open-rdc/harvesting_endeffector/claws_endeffector/stl_for_urdf/main_link.stl

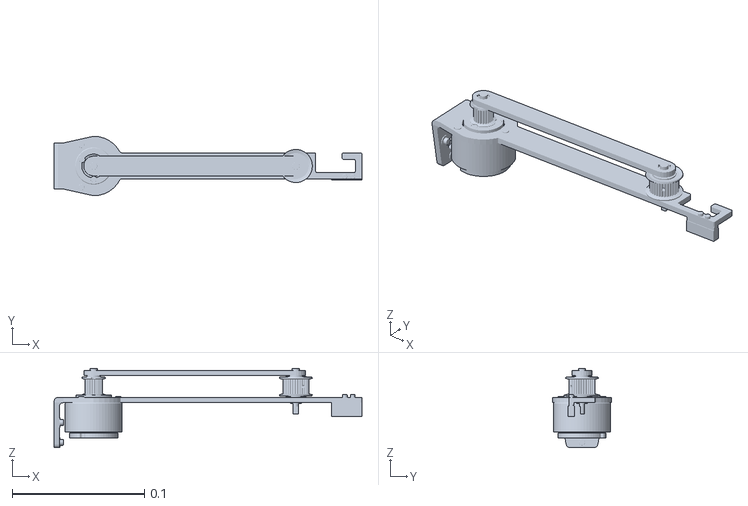
[picture p1: CAD file, 2025-06-20]
claws_endeffector/stl_for_urdf/main_link.stl
0.233 x 0.045 x 0.0599
