open-rdc/harvesting_endeffector/linear_cutting_endeffector/stl_for_urdf/main_link.stl

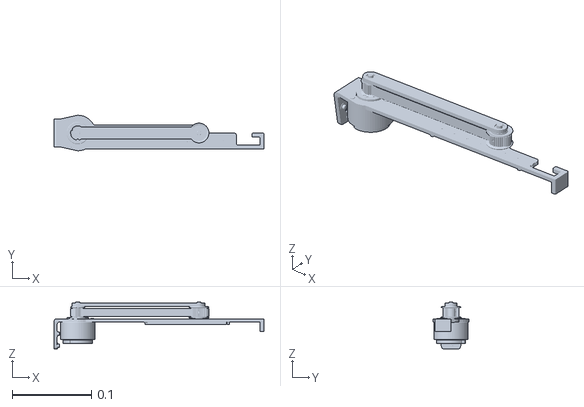
[picture p2: CAD file, 2025-06-20]
linear_cutting_endeffector/stl_for_urdf/main_link.stl
0.265 x 0.045 x 0.0592
