open-rdc/harvesting_endeffector/claws_endeffector/stl_for_urdf/wrist_link.stl

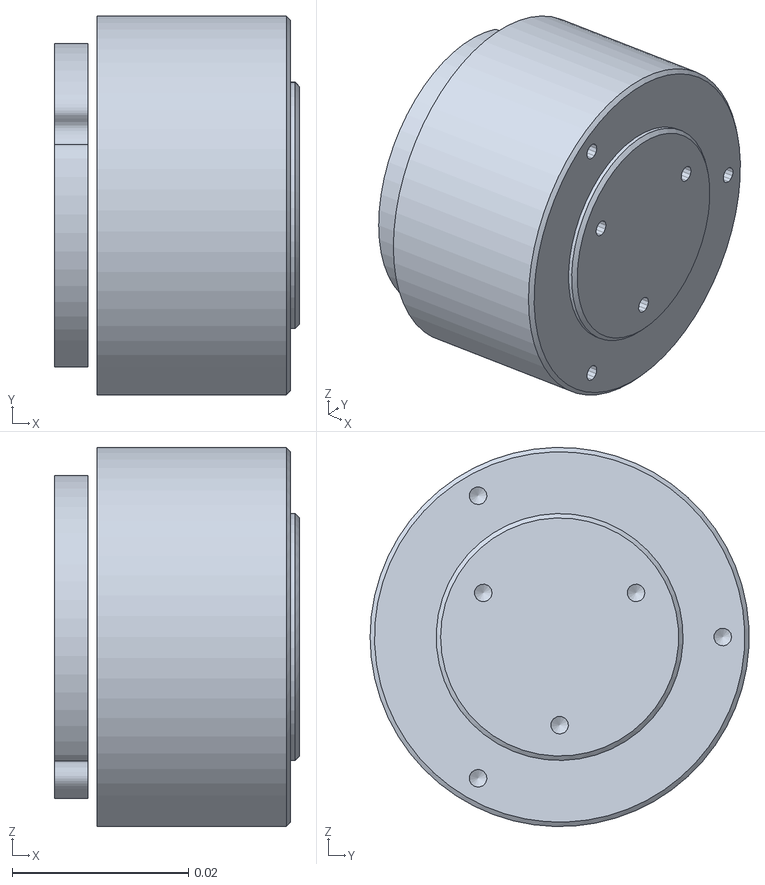
[picture p3: CAD file, 2025-06-20]
claws_endeffector/stl_for_urdf/wrist_link.stl
0.0278 x 0.043 x 0.043
