open-rdc/harvesting_endeffector/Vibrating_knife_endeffector/model/stl/knife_attachment.stl

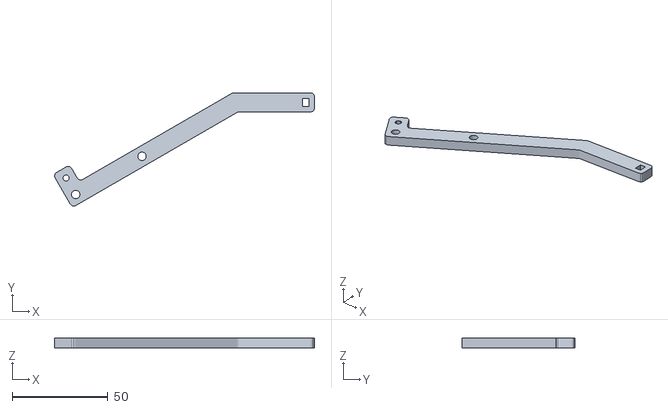
[picture p4: CAD file, 2024-10-24]
Vibrating_knife_endeffector/model/stl/knife_attachment.stl
135.9 x 59.3 x 5.00
