open-rdc/harvesting_endeffector/linear_cutting_endeffector/stl_for_urdf/cutter_link.stl

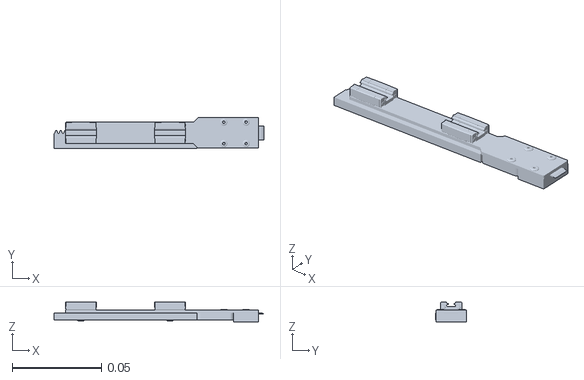
[picture p5: CAD file, 2025-06-20]
linear_cutting_endeffector/stl_for_urdf/cutter_link.stl
0.118 x 0.0171 x 0.011
