open-rdc/harvesting_endeffector/Vibrating_knife_endeffector/model/stl/stem_part.stl

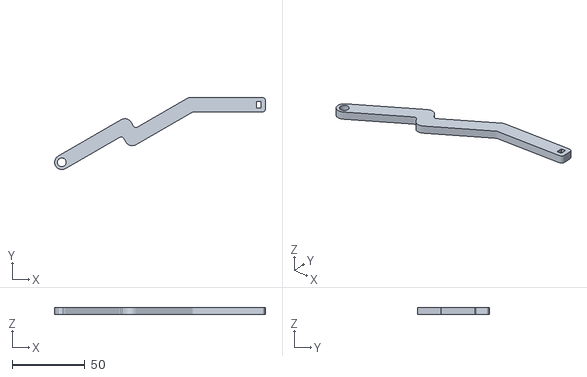
[picture p6: CAD file, 2024-10-24]
Vibrating_knife_endeffector/model/stl/stem_part.stl
144.8 x 49.4 x 5.00
