open-rdc/harvesting_endeffector/claws_endeffector/stl_for_urdf/blade_link.stl

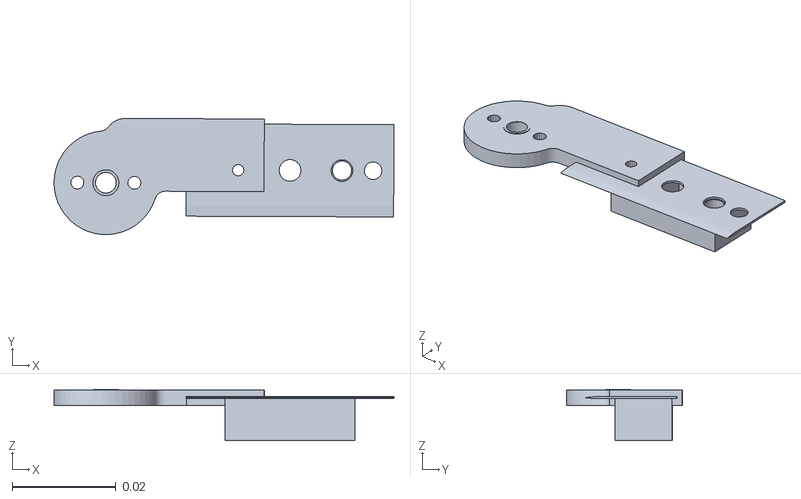
[picture p7: CAD file, 2025-06-20]
claws_endeffector/stl_for_urdf/blade_link.stl
0.0655 x 0.0224 x 0.0099
