open-rdc/harvesting_endeffector/Vibrating_knife_endeffector/model/stl/base_part_attachment_ver2.stl

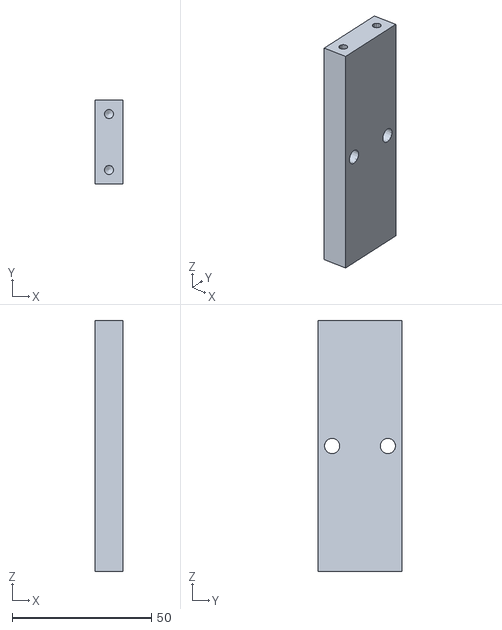
[picture p8: CAD file, 2024-10-15]
Vibrating_knife_endeffector/model/stl/base_part_attachment_ver2.stl
10.0 x 30.0 x 90.0
