open-rdc/harvesting_endeffector/Vibrating_knife_endeffector/model/stl/spacer4.4mm_in3.5mm.stl

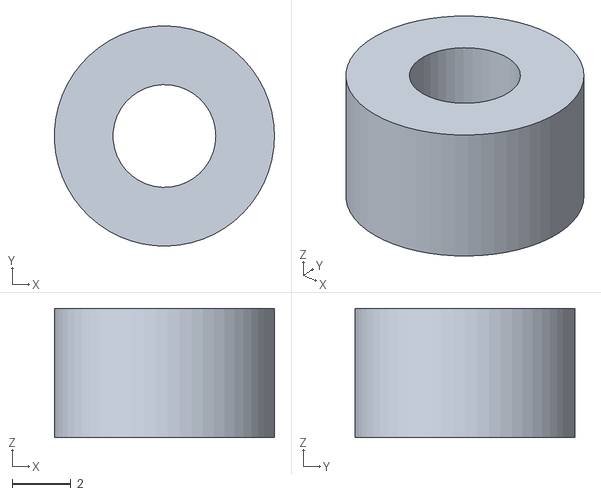
[picture p9: CAD file, 2024-10-13]
Vibrating_knife_endeffector/model/stl/spacer4.4mm_in3.5mm.stl
7.49 x 7.50 x 4.40
