open-rdc/harvesting_endeffector/Vibrating_knife_endeffector/model/stl/knife_model.stl

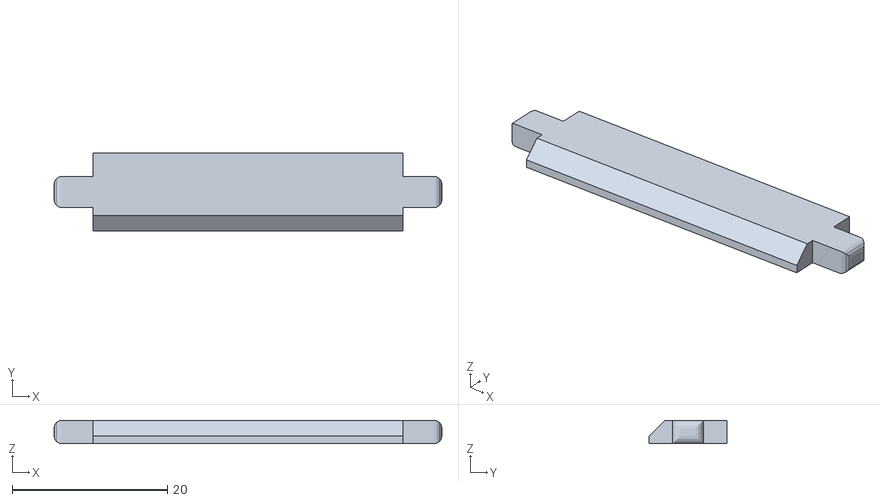
[picture p10: CAD file, 2024-10-12]
Vibrating_knife_endeffector/model/stl/knife_model.stl
50.0 x 10.0 x 3.00
