open-rdc/harvesting_endeffector/Vibrating_knife_endeffector/model/stl/spacer2mm_in3.5mm.stl

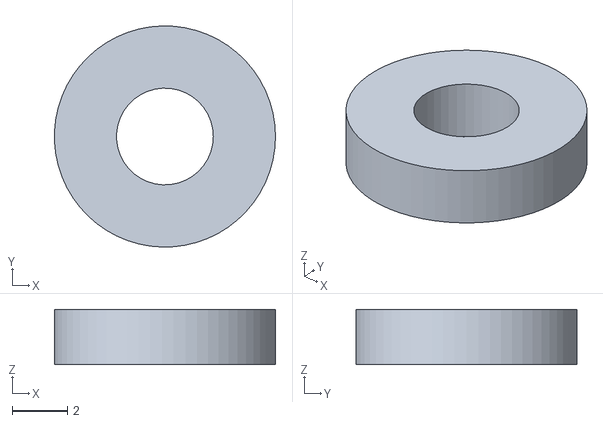
[picture p12: CAD file, 2024-10-12]
Vibrating_knife_endeffector/model/stl/spacer2mm_in3.5mm.stl
7.99 x 8.00 x 2.00
