open-rdc/harvesting_endeffector/Vibrating_knife_endeffector/model/stl/base_part_finger_ver2.stl

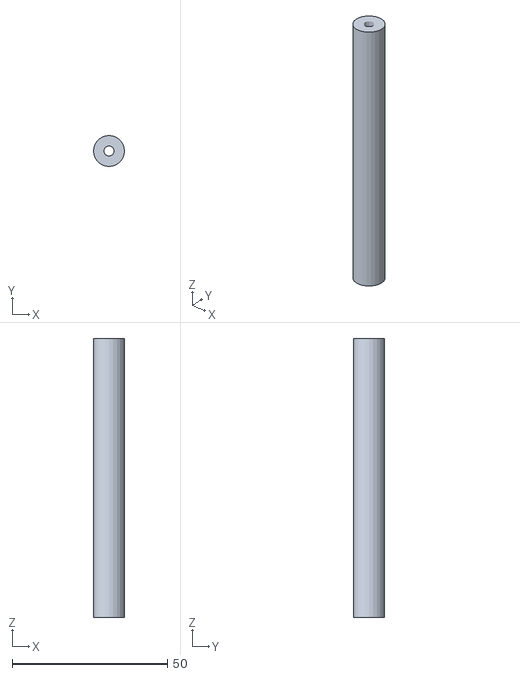
[picture p14: CAD file, 2024-10-12]
Vibrating_knife_endeffector/model/stl/base_part_finger_ver2.stl
10.0 x 10.0 x 90.0
