open-rdc/harvesting_endeffector/Vibrating_knife_endeffector/model/stl/stem_part_atachment.stl

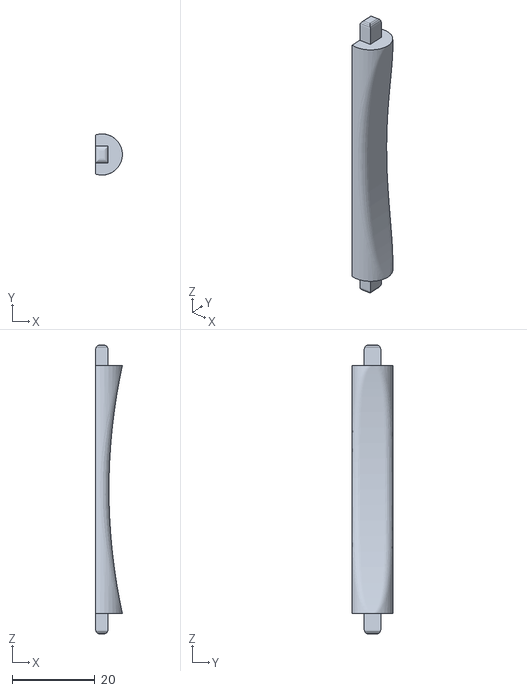
[picture p15: CAD file, 2024-10-12]
Vibrating_knife_endeffector/model/stl/stem_part_atachment.stl
6.50 x 10.0 x 70.0
