open-rdc/harvesting_endeffector/Vibrating_knife_endeffector/model/stl/spacer14mm_in3.3mm.stl

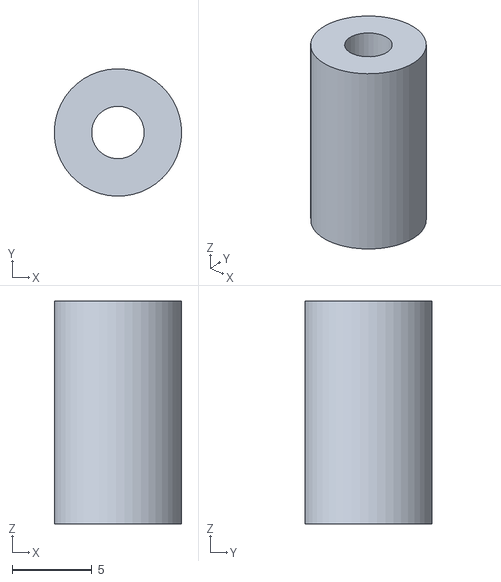
[picture p16: CAD file, 2024-10-10]
Vibrating_knife_endeffector/model/stl/spacer14mm_in3.3mm.stl
7.99 x 8.00 x 14.0
