open-rdc/harvesting_endeffector/Vibrating_knife_endeffector/model/stl/spacer4.4mm_in3.3mm.stl

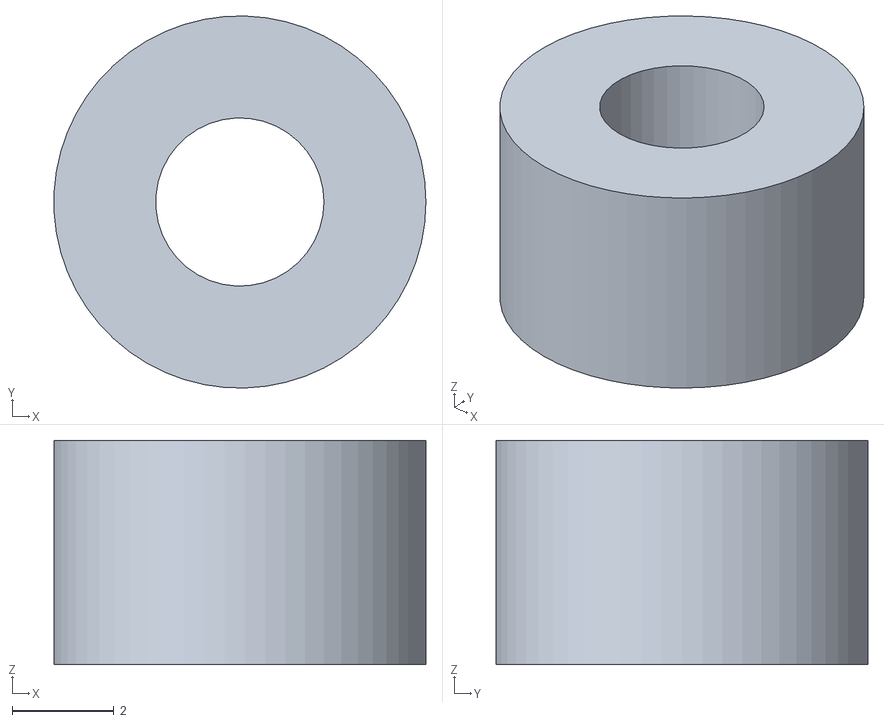
[picture p17: CAD file, 2024-10-09]
Vibrating_knife_endeffector/model/stl/spacer4.4mm_in3.3mm.stl
7.29 x 7.30 x 4.40
