open-rdc/harvesting_endeffector/Vibrating_knife_endeffector/model/stl/spacer20mm_in4.3mm.stl

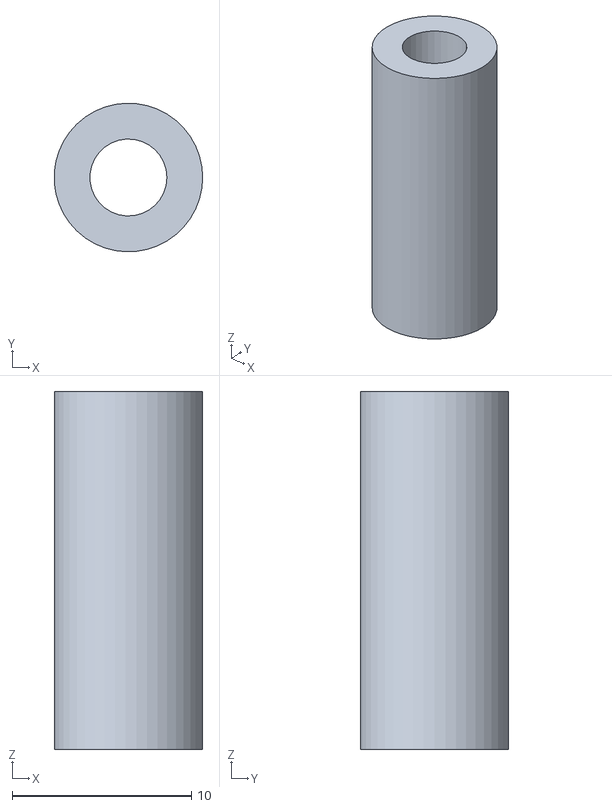
[picture p18: CAD file, 2024-10-09]
Vibrating_knife_endeffector/model/stl/spacer20mm_in4.3mm.stl
8.29 x 8.29 x 20.0
