open-rdc/harvesting_endeffector/Vibrating_knife_endeffector/model/stl/finger_M.stl

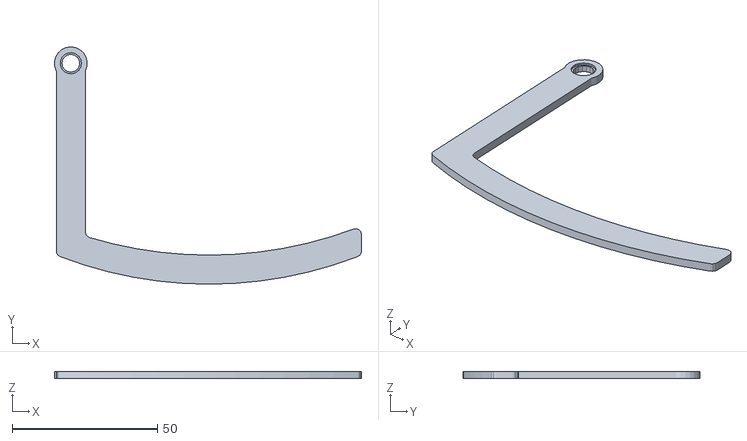
[picture p19: CAD file, 2024-10-09]
Vibrating_knife_endeffector/model/stl/finger_M.stl
105.6 x 81.7 x 2.50
