open-rdc/harvesting_endeffector/Vibrating_knife_endeffector/model/stl/finger_L.stl

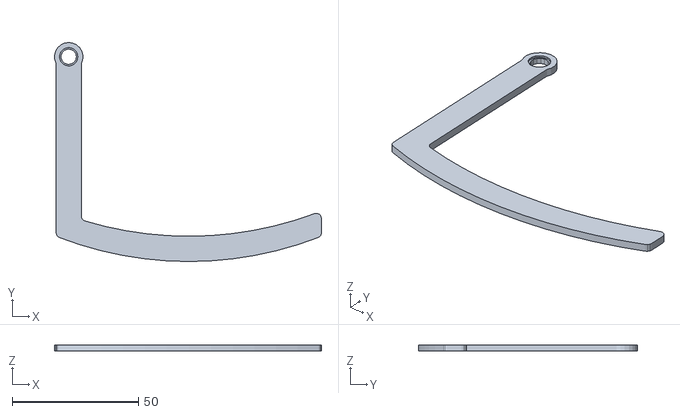
[picture p20: CAD file, 2024-10-09]
Vibrating_knife_endeffector/model/stl/finger_L.stl
105.6 x 86.7 x 2.50
