open-rdc/harvesting_endeffector/Vibrating_knife_endeffector/model/stl/base_part.stl

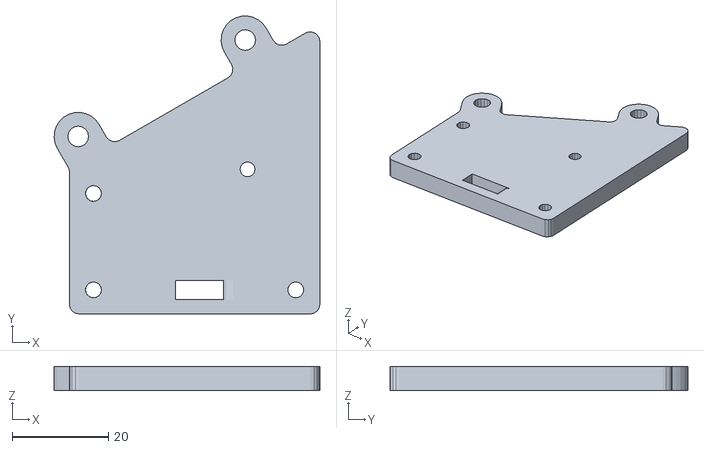
[picture p21: CAD file, 2024-10-09]
Vibrating_knife_endeffector/model/stl/base_part.stl
55.1 x 61.8 x 5.00
