open-rdc/harvesting_endeffector/Vibrating_knife_endeffector/model/stl/finger_S.stl

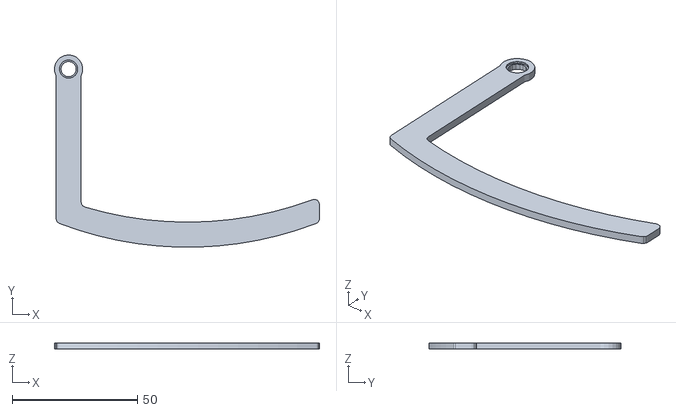
[picture p22: CAD file, 2024-10-09]
Vibrating_knife_endeffector/model/stl/finger_S.stl
105.6 x 76.6 x 2.50
