open-rdc/harvesting_endeffector/(list of files, cad)

Other CAD files:
linear_cutting_endeffector/stl_for_urdf/wrist_motor_link.stl
Vibrating_knife_endeffector/Vibration_motor.ipt
Vibrating_knife_endeffector/model/OldVersions/base_part.0003.ipt
Vibrating_knife_endeffector/model/OldVersions/base_part_attachment.0002.ipt
Vibrating_knife_endeffector/model/OldVersions/base_part_attachment_ver2.0002.ipt
Vibrating_knife_endeffector/model/OldVersions/base_part_finger_ver2.0001.ipt
Vibrating_knife_endeffector/model/OldVersions/green_pepper_model.0002.ipt
Vibrating_knife_endeffector/model/OldVersions/knife_attachment.0006.ipt
Vibrating_knife_endeffector/model/OldVersions/knife_model.0001.ipt
Vibrating_knife_endeffector/model/OldVersions/spacer14mm_in3.3mm.0004.ipt
Vibrating_knife_endeffector/model/OldVersions/spacer2.5mm_in3.3mm.0002.ipt
Vibrating_knife_endeffector/model/OldVersions/spacer20mm_in3.3mm.0002.ipt
Vibrating_knife_endeffector/model/OldVersions/spacer2mm_in3.5mm.0001.ipt
Vibrating_knife_endeffector/model/OldVersions/spacer4.4mm_in3.3mm.0002.ipt
Vibrating_knife_endeffector/model/OldVersions/stem_part.0005.ipt
Vibrating_knife_endeffector/model/OldVersions/stem_part_atachment.0001.ipt
Vibrating_knife_endeffector/model/OldVersions/vibrating_knife_model.0015.iam
Vibrating_knife_endeffector/model/OldVersions/スペーサ2.5mm_内径3.3mm.0001.ipt
Vibrating_knife_endeffector/model/OldVersions/スペーサ20mm_内径3.3mm.0001.ipt
Vibrating_knife_endeffector/model/OldVersions/スペーサ4.4mm_内径3.3mm.0001.ipt
Vibrating_knife_endeffector/model/OldVersions/スペーサ5mm_内径3.3mm.0001.ipt
Vibrating_knife_endeffector/model/OldVersions/スペーサ7mm_内径3.3mm.0002.ipt
Vibrating_knife_endeffector/model/OldVersions/ベースパーツ.0002.ipt
Vibrating_knife_endeffector/model/OldVersions/ベースパーツ1.0001.ipt
Vibrating_knife_endeffector/model/OldVersions/ベースパーツ_アーム固定部分.0001.ipt
Vibrating_knife_endeffector/model/OldVersions/ベースパーツ_実験装置取り付け部分.0001.ipt
Vibrating_knife_endeffector/model/OldVersions/刃固定パーツ.0002.ipt
Vibrating_knife_endeffector/model/OldVersions/指_中.0004.ipt
Vibrating_knife_endeffector/model/OldVersions/指_大.0002.ipt
Vibrating_knife_endeffector/model/OldVersions/指_小.0004.ipt
Vibrating_knife_endeffector/model/OldVersions/振動ナイフモデル.0005.iam
Vibrating_knife_endeffector/model/OldVersions/茎固定パーツ.0003.ipt
Vibrating_knife_endeffector/model/base_part.ipt
Vibrating_knife_endeffector/model/base_part_attachment.ipt
Vibrating_knife_endeffector/model/base_part_attachment_ver2.ipt
Vibrating_knife_endeffector/model/base_part_finger.ipt
Vibrating_knife_endeffector/model/base_part_finger_ver2.ipt
Vibrating_knife_endeffector/model/bearing_3mm.ipt
Vibrating_knife_endeffector/model/finger_L.ipt
Vibrating_knife_endeffector/model/finger_M.ipt
Vibrating_knife_endeffector/model/finger_S.ipt
Vibrating_knife_endeffector/model/green_pepper_model.ipt
Vibrating_knife_endeffector/model/knife_attachment.ipt
Vibrating_knife_endeffector/model/knife_model.ipt
Vibrating_knife_endeffector/model/spacer14mm_in3.3mm.ipt
Vibrating_knife_endeffector/model/spacer14mm_in3.5mm.ipt
Vibrating_knife_endeffector/model/spacer2.5mm_in3.3mm.ipt
Vibrating_knife_endeffector/model/spacer2.5mm_in3.5mm.ipt
Vibrating_knife_endeffector/model/spacer20mm_in4.3mm.ipt
Vibrating_knife_endeffector/model/spacer2mm_in3.5mm.ipt
Vibrating_knife_endeffector/model/spacer4.4mm_in3.3mm.ipt
Vibrating_knife_endeffector/model/spacer4.4mm_in3.5mm.ipt
Vibrating_knife_endeffector/model/spacer5mm_in3.3mm.ipt
Vibrating_knife_endeffector/model/stem_part.ipt
Vibrating_knife_endeffector/model/stem_part_atachment.ipt
Vibrating_knife_endeffector/model/stl/base_part_attachment.stl
Vibrating_knife_endeffector/model/stl/base_part_finger.stl
Vibrating_knife_endeffector/model/vibrating_knife_model.iam
claws_endeffector/OldVersions/claws_endeffector.0010.iam
claws_endeffector/OldVersions/claws_endeffector_2.0011.iam
claws_endeffector/OldVersions/claws_endeffector_3.0005.iam
claws_endeffector/OldVersions/claws_endeffector_4.0009.iam
claws_endeffector/OldVersions/claws_endeffector_5.0013.iam
claws_endeffector/OldVersions/claws_endeffector_6.0011.iam
claws_endeffector/OldVersions/claws_endeffector_7.0009.iam
claws_endeffector/OldVersions/claws_endeffector_8.0011.iam
claws_endeffector/OldVersions/claws_endeffector_8_2.0001.iam
claws_endeffector/OldVersions/claws_endeffector_8_5_rotary-blade.0016.iam
claws_endeffector/claws_endeffector.iam
claws_endeffector/claws_endeffector_2.iam
claws_endeffector/claws_endeffector_3.iam
claws_endeffector/claws_endeffector_4.iam
claws_endeffector/claws_endeffector_5.iam
claws_endeffector/claws_endeffector_6.iam
claws_endeffector/claws_endeffector_7.iam
claws_endeffector/claws_endeffector_8.iam
claws_endeffector/claws_endeffector_8_2.iam
claws_endeffector/claws_endeffector_8_5_rotary-blade.iam
claws_endeffector/cutter_part/OldVersions/cutter_XB210.0003.ipt
claws_endeffector/cutter_part/OldVersions/cutter_board-2.0005.ipt
claws_endeffector/cutter_part/OldVersions/cutter_board.0005.ipt
claws_endeffector/cutter_part/OldVersions/cutter_board_claws_endeffector_8.0007.ipt
claws_endeffector/cutter_part/OldVersions/cutter_board_claws_endeffector_8_5_rotary-blade-2.0006.ipt
claws_endeffector/cutter_part/OldVersions/cutter_board_claws_endeffector_8_5_rotary-blade.0001.ipt
claws_endeffector/cutter_part/OldVersions/cutter_holder.0001.ipt
claws_endeffector/cutter_part/OldVersions/cutter_stopper.0004.ipt
claws_endeffector/cutter_part/OldVersions/griper_TPU.0003.ipt
claws_endeffector/cutter_part/OldVersions/griper_base_TPU.0001.ipt
claws_endeffector/cutter_part/OldVersions/gripping_base.0001.ipt
claws_endeffector/cutter_part/OldVersions/homemade_setcolor.0001.ipt
claws_endeffector/cutter_part/cutter.ipt
claws_endeffector/cutter_part/cutter_XB210.ipt
claws_endeffector/cutter_part/cutter_board-2.ipt
claws_endeffector/cutter_part/cutter_board.ipt
claws_endeffector/cutter_part/cutter_board_claws_endeffector_8.ipt
claws_endeffector/cutter_part/cutter_board_claws_endeffector_8_5_rotary-blade-2.ipt
claws_endeffector/cutter_part/cutter_board_claws_endeffector_8_5_rotary-blade.ipt
claws_endeffector/cutter_part/cutter_board_for_stl.ipt
claws_endeffector/cutter_part/cutter_holder.ipt
claws_endeffector/cutter_part/cutter_stopper.ipt
claws_endeffector/cutter_part/griper_TPU-2.ipt
claws_endeffector/cutter_part/griper_TPU.ipt
claws_endeffector/cutter_part/griper_base_TPU-2.ipt
claws_endeffector/cutter_part/griper_base_TPU.ipt
claws_endeffector/cutter_part/gripping_base.ipt
claws_endeffector/cutter_part/homemade_setcolor-2.ipt
claws_endeffector/cutter_part/homemade_setcolor.ipt
claws_endeffector/cutter_part/nitrile_rubber.ipt
claws_endeffector/cutter_part/sponge.ipt
claws_endeffector/jig/OldVersions/piper-GIM3505-8.0001.ipt
claws_endeffector/jig/OldVersions/piper-demo_model.0002.ipt
claws_endeffector/jig/homemade_setcolor-2_jig.ipt
claws_endeffector/jig/laboratory_equipment-GIM3505-8.ipt
claws_endeffector/jig/piper-GIM3505-8.ipt
claws_endeffector/jig/piper-demo_model.ipt
claws_endeffector/linear_actuator/OldVersions/rail.0001.ipt
claws_endeffector/linear_actuator/linear_slider.iam
claws_endeffector/linear_actuator/rail.ipt
claws_endeffector/linear_actuator/slider.ipt
claws_endeffector/misumi/CLBU4-7-1_Autodesk_Inventor_2024_20250305/CLBU4-7-1.ipt
claws_endeffector/misumi/HTBN360S2M-60_Inventor/HTBN360S2M-60.ipt
claws_endeffector/misumi/HTPA22S2M060-A-H4_Autodesk_Inventor_2024_20250419/AIS2024/HTPA22S2M060-A-H4.iam
claws_endeffector/misumi/HTPA22S2M060-A-H4_Autodesk_Inventor_2024_20250419/AIS2024/HTPA22S2M060-A-H4_a-2.ipt
claws_endeffector/misumi/HTPA22S2M060-A-H4_Autodesk_Inventor_2024_20250419/AIS2024/HTPA22S2M060-A-H4_a.ipt
claws_endeffector/misumi/HTPA22S2M060-A-H4_Autodesk_Inventor_2024_20250419/AIS2024/OldVersions/HTPA22S2M060-A-H4_a-2.0003.ipt
claws_endeffector/misumi/HTPA22S2M100-K-P4_Autodesk_Inventor_2024_20250304/AIS2024/HTPA22S2M100-K-P4.iam
claws_endeffector/misumi/HTPA22S2M100-K-P4_Autodesk_Inventor_2024_20250304/AIS2024/HTPA22S2M100-K-P4_a.ipt
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
