open-rdc/harvesting_endeffector/(threads)

Thread 1 (2025-03-05):

設計に関して

yasuohayashibara, 2025-03-05:
設計に関する意見

yasuohayashibara, 2025-03-05:
１）プーリに追加する部品
型番で調べてみましたが，形状が異なりますので，追加の部品が必要になると思います．
このプーリに部品を追加するのは形状が複雑なので少々厄介だと思います．
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

２）ピッタリのサイズで製作するとはめるのが難しく，軸に大きな力を加えることになるかもしれない．
プーリーにはアイドラなどを使用することが一般的．
（利用経験があれば大丈夫ですが，比較的大変です．）
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

３）シャフトとアームの固定法
どのように固定するかで，強度が変わるが，面積的には不十分かもしれない．
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

４）ベアリングのスペーサ
「ベアリング用スペーサ　内輪用」と記載されていますので，大丈夫かもしれませんが，CADを見ると外輪と干渉しています．
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

yasuohayashibara, 2025-03-07:
@yasuohayashibara
コメントありがとうございます．
こちらに修正案を記載したいと思います．
質問も併せて記入しますので，回答いただけますと幸いです．

### 1) プーリに追加する部品
> こちらの部品ですが，まずプリンタで作成することを想定していました．

承知しました．

### 2) プーリのアイドラ使用について
> プーリの設計経験がないので入れなかったのですが，必要ならばこちらも設計に組み込み注文しようと思います．
> https://jp.misumi-ec.com/vona2/detail/110310461249/?rid=dj_sub1_detail_2_110310461249_e01_110302650750

こちらしっかりしたアイドラですが，支えられればもっと簡易的なものでも構いません．

### 3) シャフトとアームの固定法
> こちらどのような固定方法が良いでしょうか？
> 面積的に不十分ということですが，どのような固定方法だと問題を解決できますか？

分解するかどうかで変わりますが，分解しないのであれば板厚を大きくして，圧入もしくは接着かなと思います．
圧入　https://jp.meviy.misumi-ec.com/info/ja/blog/ogawa/18144/

分解するのであれば，このサイズのものには使用することは少ないと思いますが，以下のような部品を使用したりします．
https://jp.misumi-ec.com/vona2/detail/110300018410/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

### 4) 5) ベアリングのスペーサ
> ベアリングスペーサ 内輪用と書いてあったので使えると思ったのですが，外輪に接触しているということで，部品の変更を検討します.

承知しました．

### 6) 鋭角について
> こちらの部分にフィレットを追加します．
> また，このパーツですがアルミの板金を購入し，工作センタに依頼を出すことは可能でしょうか？
> 大学の工作センタならば，ワイヤーカッタがあったと思うので，そちらに加工依頼が出せるか検討したいです．

できますが，穴あけは自分で行うことが必要です．
穴あけの精度が必要であれば外注したほうが良いかもしれません．

### 7) 土台への固定方法
> 使用するモータのドライバがある面にネジ穴があったと思うので，そちらに固定しようと考えていました．
> 前面で固定するのであれば，この形状だと厳しいので再度考える必要があると思います．
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

川鍋君が使用した実物が研究室にあるので，そちらを見て判断してください．

### 8) カッターの動き
> おっしゃる通りこの形状では枝が逃げていく可能性があります．
> [湾曲タイプのカッタ]>
(https://www.amazon.co.jp/%E7%82%AD%E7%B4%A0%E9%8B%BC%E3%83%A1%E3%82%B9%E3%81%AE%E5%88%83-%E3%82%AF%E3%83%A9%E3%83%95%E3%83%88-%E8%A7%A3%E5%89%96%E3%81%AA%E3%81%A9-%E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)
> このような先の方が曲がっているカッタを採用する必要があると考えています．
> ご意見お願いします．

試してみるのが良いと思います．

### 質問
> 使用予定のモータをcan通信するときの変換機があれば教えていただけますと幸いです．

amazonですが，林原はこちらを使用しました．
https://www.amazon.co.jp/gp/product/B0BQ5G3KLR/ref=ppx_yo_dt_b_search_asin_title?ie=UTF8&psc=1

kentotutui, 2025-03-10:
@yasuohayashibara
頂いたコメントを基にCADを変更しています．
完了次第pushします．

こちらのリンクで購入するものをまとめています．
https://docs.google.com/spreadsheets/d/1MS4pV-U8-zxloit8WTfRLT7rH19TnEEjm3ThxvGljOc/edit?gid=0#gid=0

ワークロボティクスへの発注ですが，見積もりを取った後に大学事務から発注になるのでしょうか？

yasuohayashibara, 2025-03-10:
@kentotutui
> ワークロボティクスへの発注ですが，見積もりを取った後に大学事務から発注になるのでしょうか？

10万円以下の場合，大学の承認を得た後，林原から発注することになります．

kentotutui, 2025-03-10:
@yasuohayashibara
現状のリストでワークロボティクスに見積もりをお願いします．
見積もりと納期が分かり次第，林原先生にお伝えします．

kentotutui, 2025-03-10:
@yasuohayashibara
アセンブリファイルを更新しました．
（claws_endeffector_3.iamを新しく作りました）
https://github.com/open-rdc/harvesting_endeffector/blob/main/claws_endeffector/claws_endeffector_3.iam

刃はついていません

yasuohayashibara, 2025-03-10:
以下，コメントです．
はじめの試作の設計としてはこれで良いと思います．
（改善点は対処し始めるときりがありませんので．．．）

以下，些細なことですが，コメントです．

１）ザグリに関して（変更しなくて構いません）
以下のザグリはあっても良いですが，単価が上がりそうであれば無くても良いと思います．
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

２）ネジの長さ
できるだけ長いネジを入れて下さい．
深さにも公差がありますので，あまりギリギリはよくありませんが，固定の強度とゆるみやすさが変わりますので長いほうが良いです．
今の長さでも許容範囲ではありますので，ネジの種類を減らしてメンテナンスしやすさを重視するということであれば，それでも構いません．
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

３）上記「7) 土台への固定方法」ですが，引き続きご検討下さい．
後で考えても良い項目だと思います．

Thread 2 (2025-03-12):

ワクロボから届いた見積書

kentotutui, 2025-03-12:
@yasuohayashibara
ワークロボティクスから見積書が届きました．
10万円を超えているので，大学事務からの発注になり，備品扱いとなりそうです．
[エンドエフェクタ部品御見積書.pdf](https://github.com/user-attachments/files/19200668/default.pdf)

yasuohayashibara, 2025-03-12:
10万円超えましたので，備品になり大学からの発注になります．
他に必要な書類を用意するようにしてください．

kentotutui, 2025-03-12:
[選定理由書.docx](https://github.com/user-attachments/files/19207276/default.docx)

[エンドエフェクタVer.202503Aキット御見積書.pdf](https://github.com/user-attachments/files/19207277/Ver.202503A.pdf)

[エンドエフェクタVer.202503Aキット_仕様書.pdf](https://github.com/user-attachments/files/19207279/Ver.202503A._.pdf)

ワークロボティクス保坂様が上記書類を作成いただきました．

> 見積書と仕様書になります。選定理由書に関しては案を作ってみましたので参考にしてください。
　いったんは見積書と仕様書で申請してみてください。
選定理由書は必要と言われてから出す形でも良いかと思います。

yasuohayashibara, 2025-03-13:
事務からの回答

-----

林原先生
CC研究支援担当　加藤様

お世話になります。
大林＠用度担当でございます。
GAKUENの調達物申請登録の決済依頼メールが届きました。

・価格の分かる資料をお持ちでしたらご提供下さい。
　※図面が付いておりますが受注(特注)でしょうか。

・発注先のご担当者、メールアドレス　をご存じでしたら教えて下さい。

どうぞよろしくお願い致します。

Thread 3 (2025-06-07):

直動切断機構を搭載したエンドエフェクタの設計

kentotutui, 2025-06-07:
@yasuohayashibara
https://github.com/open-rdc/harvesting_endeffector/tree/main/linear_cutting_endeffector

こちらのフォルダで直動切断機構を搭載したエンドエフェクタを設計中です．

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

いくつか質問がありますので回答いただき，設計に反映させたいと思います．

### 1. ピニオンギアの隙間について

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

ラック＆ピニオンにて直動動作を行おうと考えていますが，ピニオンギアのスペースをどのようにすれば良いかわかりません．
ピニオンギアはシャフトとメタルロックで締結を考えています．
(ラックはMCナイロン，ピニオンは真鍮)

### 2. リニアスライダとラックの締結

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

ラックとスライダの締結をネジで行いたいのですが，選定した部品はラックがΦ3.5，スライダはM2が開いておりM2の六角穴付きネジなどを締結する際に少し心配です．このような場合どのようにすればよいでしょうか？

その他アドバイスや修正点があればお願いします．

kentotutui, 2025-06-08:
@yasuohayashibara
直動時に得られる力を計算しました．

モータの定常トルク0.43Nm，タイミングベルトの減速比32:22，ピニオンギアM=0.8，歯数24，ピッチ円半径9.6mm

F_rack = (0.43 * (32/22)) / (9.6/1000) * cos(20°) = 約61N

kentotutui, 2025-06-08:
### 1. ピニオンギアの隙間について
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
説明が分かりにくくて申し訳ありません．ピニオンギアの隙間は画像赤枠の部分になります．

1つの軸受けで支えているので少々不安です．

また，林原先生ご指摘の軸間距離ですが，ぴったりに設計してしまいました．
Y軸方向に0.1~0.2mmほどずらします．

メタルロックですが，接着した後でも熱を加えることで外すことができます．

kentotutui, 2025-06-09:
@yasuohayashibara
ピニオンギアの隙間はどのようにすれば良いでしょうか？

yasuohayashibara, 2025-06-09:
こんな感じかなと思います．
下と同じベアリングを挟んで外径の小さなボス付きのピニオン（例：GEFHBS0.8-24-4-5-W5-H7）か，外径の小さなスペーサを入れてピニオンを接着で固定するというのが一つの方法です
ただし，よく見たら黄色のところで干渉していますので，ベアリングを埋め込まないとだめですね．
あと，スライダとピニオンが干渉しないように気をつけてください．

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

kentotutui, 2025-06-10:
@yasuohayashibara

ベアリングを埋め込む余裕ですが，現在作成している回転刃のエンドエフェクタが以下の写真のようになります．
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
ベアリングがギリギリですが，一応作成できそうです．
フランジとスライダが干渉する部分ですが，スライダを1mm埋め込んでいる部分を少し出そうと考えています．
ピニオンとスペーサに関してはもう少し考えます．

kentotutui, 2025-06-10:
@yasuohayashibara
ラック-スライダ固定のためのパイプですが，以下のようなものを旋盤で加工し，ラックに熱圧入を考えていますがいかがでしょうか？

外径Φ3.6
内径Φ2.2
L=4
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

ラックはMCナイロン

yasuohayashibara, 2025-06-10:
お疲れ様です．
見た感じ素材はアルミのようですね．
大変ですが，昔は全てそれで加工していましたので懐かしいです．

yasuohayashibara, 2025-06-13:
コメント

１）シャフトに凹みをつける
このままだとプーリとシャフトが滑るので，シャフトに凹みをつけてください．
業者にお願いできれば楽ですが，追加工でも良いと思います．
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

２）強度が問題になるかも知れません．
最大6kgで押したときに金属であれば大丈夫だと思いますが，樹脂であれば曲がったり，折れたりするかもしれません．
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

後は動かしながら考えるで良いと思います．

Thread 4 (2025-07-10):

かま型エンドエフェクタ Ver.2の作成

kentotutui, 2025-07-10:
@yasuohayashibara
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

7月末の圃場実験で使用するエンドエフェクタを設計しました．
以下の点についてご意見いただければと思います．

https://github.com/open-rdc/harvesting_endeffector/tree/main/linear_cutting_endeffector-2
**↑こちらのlinear_cutting_endeffector4.iamが最新のものになります．**

- ベアリングポケットとスライダポケットが肉薄
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
この部分が肉薄となってしまいました．
一応meviyに入れたところ，見積もりを取ることができ，製造可能と出ましたが心配なのでご意見いただければと思います．
材質はアルミ6061を想定しています．

- ベースとロール軸モータの固定

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
切断モータとロール駆動のパーツを分けたので，固定方法がこれで良いのかよくわかりません．
下から2点M3で固定 + L字パーツを使い固定をしていますが，ご意見あればお願いします．

- 全長が非常に長い
奥にあるピーマンまで届くように長めに設計したところ，約350mmほどになってしまいました．
従来の長さのものも設計しておいた方が良いでしょうか？
また，設計した長さでも問題ないでしょうか？

- そのほかにも気になることがあればお願いいたします．
