open-rdc/harvesting_endeffector/(commit log)

2024-09-23 add iptdate
    [body.0002.ipt, body.ipt, finley_gripper.ipt, linear_slider.0003.iam, linear_slider.iam, moving_part.0002.ipt, moving_part.ipt, shaft.0001.ipt]
2024-09-23 rename finley_gripper
    [finley_gripper_80.ipt]
2024-09-23 add finley_gripper_60
    [finley_gripper_60.0001.ipt, finley_gripper_60.ipt]
2024-10-02 add vibration_motor
    [Vibration_motor.ipt]
2024-10-06 add demo_finley_gripper.iam
    [base.ipt, demo_finley_gripper.0003.iam, demo_finley_gripper.iam, finlay_holds_board.ipt, finlay_holds_down.ipt]
2024-10-06 update material demo_finley_gripper
    [body.0002.ipt, body.0003.ipt, body.ipt, demo_finley_gripper.0003.iam, demo_finley_gripper.0004.iam, demo_finley_gripper.iam, finlay_holds_board.0006.ipt, finlay_holds_board.ipt]
2024-10-09 add vibrating knife model
    [base_part.0003.ipt, base_part.ipt, base_part.stl, base_part_attachment.0002.ipt, base_part_attachment.ipt, base_part_attachment.stl, base_part_finger.ipt, base_part_finger.stl]
2024-10-10 fixed spacer14mm
    [spacer14mm_in3.3mm.0003.ipt, spacer14mm_in3.3mm.ipt, spacer14mm_in3.3mm.stl, vibrating_knife_model.0008.iam, vibrating_knife_model.0010.iam, vibrating_knife_model.iam]
2024-10-11 add demo_rod_endeffector
    [VP16_200.0001.ipt, demo_finley_gripper.0004.iam, demo_finley_gripper.0005.iam, demo_finley_gripper.iam, rod_fixture_vp13.ipt, rod_fixture_vp16.ipt, vp13_150.ipt, vp13_200.0001.ipt]
2024-10-12 add scissor_parts
    [demo_finley_gripper.0005.iam, demo_finley_gripper.0006.iam, demo_finley_gripper.iam, scissor.ipt, scissor_fixing_parts.ipt]
2024-10-12 穴サイズ修正
    [base_part_attachment_ver2.ipt, base_part_attachment_ver2.stl, base_part_finger_ver2.ipt, base_part_finger_ver2.stl, knife_attachment.0003.ipt, knife_attachment.0005.ipt, knife_attachment.ipt, knife_attachment.stl]
2024-10-13 add stl
    [spacer4.4mm_in3.5mm.stl]
2025-01-22 add demo_square_bar_endeffector
    [M3×6screw.ipt, blade.0001.ipt, blade.ipt, demo_square_bar_endeffector.0002.iam, demo_square_bar_endeffector.iam, square_bar.0004.ipt, square_bar.ipt, square_ber_holder.0001.ipt]
2025-03-05 add claws_endeffector
    [GIM3505-8_with-driver.ipt, HTBN360S2M-100_info-1-16-16.ipt, HTPA22S2M100-A-V4-Z6-J3_0.iam, HTPA22S2M100-A-V4-Z6-J3_0_a.0003.ipt, HTPA22S2M100-A-V4-Z6-J3_0_a.ipt, HTPA22S2M100-K-P4.iam, HTPA22S2M100-K-P4_a.ipt, KESS2-6.ipt]
2025-03-05 add Pulley material
    [HTPA22S2M100-A-V4-Z6-J3_0_a.0003.ipt, HTPA22S2M100-A-V4-Z6-J3_0_a.0004.ipt, HTPA22S2M100-A-V4-Z6-J3_0_a.ipt, HTPA22S2M100-K-P4_a.0001.ipt, HTPA22S2M100-K-P4_a.ipt]
2025-03-05 update timing pulley
    [HTPA22S2M100-A-V4-Z6-J3_0_a.0004.ipt, HTPA22S2M100-A-V4-Z6-J3_0_a.0006.ipt, HTPA22S2M100-A-V4-Z6-J3_0_a.ipt, claws_endeffector_2.0003.iam, claws_endeffector_2.0008.iam, claws_endeffector_2.iam, cutter_board.0001.ipt, cutter_board.ipt]
2025-03-05 add bearing spacer
    [CLBU4-7-1.ipt, claws_endeffector_2.0008.iam, claws_endeffector_2.0010.iam, claws_endeffector_2.iam, cutter_XB210.ipt]
2025-03-10 add claws_endeffector_3.iam
    [Hexagon socket set screw with flat point DIN 913 - M3x3.ipt, M3×8.ipt, SSCMN4.iam, SSCMN4b.ipt, claws_endeffector.0009.iam, claws_endeffector.0010.iam, claws_endeffector.iam, claws_endeffector_3.0001.iam]
2025-03-10 add M2.5 × 4
    [claws_endeffector_3.0001.iam, claws_endeffector_3.0002.iam, claws_endeffector_3.iam, motor_holder_3.0003.ipt, motor_holder_3.0004.ipt, motor_holder_3.ipt]
2025-03-24 add M2.5×4 screw
    [claws_endeffector_2.0010.iam, claws_endeffector_2.0011.iam, claws_endeffector_2.iam, claws_endeffector_3.0002.iam, claws_endeffector_3.0005.iam, claws_endeffector_3.iam]
2025-03-25 add claws_endeffector_4.iam
    [HTPA22S2M100-A-V4-Z6-J3_0_a-2.0011.ipt, HTPA22S2M100-A-V4-Z6-J3_0_a-2.ipt, claws_endeffector_4.0007.iam, claws_endeffector_4.iam, motor_holder_4.0005.ipt, motor_holder_4.ipt, motor_holder_top.0001.ipt, motor_holder_top.ipt]
2025-04-03 add jig
    [HTPA22S2M100-A-V4-Z6-J3_0_a-2.0011.ipt, HTPA22S2M100-A-V4-Z6-J3_0_a-2.0012.ipt, HTPA22S2M100-A-V4-Z6-J3_0_a-2.ipt, claws_endeffector_4.0007.iam, claws_endeffector_4.0008.iam, claws_endeffector_4.iam, piper-GIM3505-8.ipt]
2025-04-04 add claws_endeffector_5.iam
    [GIM3505-8_with-driver.0003.ipt, GIM3505-8_with-driver.ipt, HTBN360S2M-100_info-1-16-16.0001.ipt, HTBN360S2M-100_info-1-16-16.ipt, HTPA22S2M100-A-V4-Z6-J3_0_a-3.0010.ipt, HTPA22S2M100-A-V4-Z6-J3_0_a-3.ipt, HTPA32S2M100-A-P4.iam, HTPA32S2M100-A-P4_a.0001.ipt]
2025-04-23 add claws_endeffector_6.iam
    [HTBN360S2M-60.ipt, HTPA22S2M060-A-H4.iam, HTPA22S2M060-A-H4_a-2.0003.ipt, HTPA22S2M060-A-H4_a-2.ipt, HTPA22S2M060-A-H4_a.ipt, HTPA32S2M060-A-P4.0002.iam, HTPA32S2M060-A-P4.iam, HTPA32S2M060-A-P4_a.0001.ipt]
2025-04-23 add laboratory_equipment-GIM3505-8.ipt
    [laboratory_equipment-GIM3505-8.ipt]
2025-05-17 add claws_endeffector_7 part
    [HTPA32S2M100-A-P4.0001.iam, HTPA32S2M100-A-P4.iam, claws_endeffector_5.0011.iam, claws_endeffector_5.0012.iam, claws_endeffector_5.iam, claws_endeffector_6.0008.iam, claws_endeffector_6.0008_1.iam, claws_endeffector_6.0011.iam]
2025-05-17 add Timing belt
    [claws_endeffector_7.0007.iam, claws_endeffector_7.0008.iam, claws_endeffector_7.iam]
2025-05-18 add claws_endeffector_8 part
    [claws_endeffector_8.0006.iam, claws_endeffector_8.iam, cutter_board_claws_endeffector_8.0006.ipt, cutter_board_claws_endeffector_8.ipt, motor_holder_8.0009.ipt, motor_holder_8.ipt]
2025-05-25 add claws_endeffecter_8_2
    [claws_endeffector_5.0012.iam, claws_endeffector_5.0013.iam, claws_endeffector_5.iam, claws_endeffector_7.0008.iam, claws_endeffector_7.0009.iam, claws_endeffector_7.iam, claws_endeffector_8.0006.iam, claws_endeffector_8.0010.iam]
2025-05-28 add motor_holder 8-3 8-4
    [motor_holder_8-3.ipt, motor_holder_8-4.ipt]
2025-05-30 add motor_holder_8-5
    [motor_holder_8-5.ipt]
2025-06-01 add linear_slider
    [claws_endeffector_8.0010.iam, claws_endeffector_8.0011.iam, claws_endeffector_8.iam, claws_endeffector_8_2.0001.iam, claws_endeffector_8_2.iam, linear_slider.iam, rail.0001.ipt, rail.ipt]
2025-06-02 add claws_endeffector_8_5_rotary-blade
    [HTPA32S2M100-A-P4_a.0001.ipt, HTPA32S2M100-A-P4_a.0003.ipt, HTPA32S2M100-A-P4_a.ipt, M2×6.ipt, claws_endeffector_8_5_rotary-blade.0005.iam, claws_endeffector_8_5_rotary-blade.iam, cutter_XB210.0001.ipt, cutter_XB210.0002.ipt]
2025-06-02 update claws_endeffector_8_5
    [claws_endeffector_8_5_rotary-blade.0005.iam, claws_endeffector_8_5_rotary-blade.0006.iam, claws_endeffector_8_5_rotary-blade.iam, motor_holder_8-5.0002.ipt, motor_holder_8-5.0003.ipt, motor_holder_8-5.ipt]
2025-06-03 update claws_endeffector_8_5_rotary-blade
    [BFBJ2-4.ipt, E-GCBSTSR3-5.ipt, SLBNR2.ipt, claws_endeffector_8_5_rotary-blade.0006.iam, claws_endeffector_8_5_rotary-blade.0010.iam, claws_endeffector_8_5_rotary-blade.iam, cutter_board_claws_endeffector_8_5_rotary-blade-2.0003.ipt, cutter_board_claws_endeffector_8_5_rotary-blade-2.0004.ipt]
2025-06-07 add pen type cutter
    [pen_type_cutter.ipt]
2025-06-07 add linear_cutting_endeffector
    [C-FL675ZZ.ipt, GIM3505-8_with-driver.0003.ipt, GIM3505-8_with-driver.ipt, HTPA22S2M100-A-V4-Z6-J3_0.iam, HTPA22S2M100-A-V4-Z6-J3_0_a-2.0012.ipt, HTPA22S2M100-A-V4-Z6-J3_0_a-2.ipt, HTPA22S2M100-A-V4-Z6-J3_0_a-3.0010.ipt, HTPA22S2M100-A-V4-Z6-J3_0_a-3.ipt]
2025-06-10 update linear_cutting_endeffector-2
    [CLBUS5-8-5.ipt, LRGEAM0_8KA-80-K2-B50.0001.ipt, LRGEAM0_8KA-80-K2-B50.ipt, M2×6.ipt, Spur Gear (24 teeth).0001.ipt, Spur Gear (24 teeth).ipt, claws_endeffector_8_5_rotary-blade.0015.iam, claws_endeffector_8_5_rotary-blade.0016.iam]
2025-06-12 add pen_type_cutter_realsize.ipt
    [linear_cutting_endeffector-2.0015.iam, linear_cutting_endeffector-2.0016.iam, linear_cutting_endeffector-2.iam, linear_cutting_endeffector-3.0003.iam, linear_cutting_endeffector-3.iam, linear_cutting_endeffector_idea.newVer.iam, motor_holder-2.0016.ipt, motor_holder-2.0018.ipt]
2025-06-12 add linear_cutting_endeffector-4
    [CBSTSR2-3.ipt, CBSTSR2-8.ipt, CLBPS5-8-6_3.ipt, CLBPS5-8-7.ipt, cutter_holder-2.0005.ipt, cutter_holder-2.ipt, linear_cutting_endeffector-3.0003.iam, linear_cutting_endeffector-3.0009.iam]
2025-06-12 update linear_cutting_endeffector-5
    [HTBN360S2M-100_info-1-16-16.0001.ipt, HTBN360S2M-100_info-1-16-16.ipt, linear_cutting_endeffector-5.0018.iam, linear_cutting_endeffector-5.0019.iam, linear_cutting_endeffector-5.iam]
2025-06-14 add linear_cutting_endeffector-5-add_cutter_stopper
    [cutter_stopper-2.0001.ipt, cutter_stopper-2.ipt, cutter_stopper.0030.ipt, cutter_stopper.ipt, linear_cutting_endeffector-5-add_cutter_stopper.iam, linear_cutting_endeffector-5.0024.iam, linear_cutting_endeffector-5.0026.iam, linear_cutting_endeffector-5.iam]
2025-06-20 add stl file
    [blade_link.stl, cutter_link.stl, main_link.stl, wrist_link.stl, wrist_motor_link.stl]
2025-06-21 update linear_cutting_endeffector griper-part
    [cutter_holder-2.0006.ipt, cutter_holder-2.0009.ipt, cutter_holder-2.ipt, greiper_TPU-2.0006.ipt, greiper_TPU-2.ipt, greiper_TPU.0003.ipt, greiper_TPU.0004.ipt, greiper_TPU.ipt]
2025-06-21 add Multiple types gripper_TPU
    [greiper_TPU-4mm-thick.0005.ipt, greiper_TPU-4mm-thick.ipt, greiper_TPU-4mm.ipt, greiper_TPU-5mm-thick.0007.ipt, greiper_TPU-5mm-thick.ipt, greiper_TPU-5mm.0006.ipt, greiper_TPU-5mm.ipt, greiper_TPU-thick.0005.ipt]
